jamesfletcher22/NortonAmps/Norton Amps Schematic.pdf

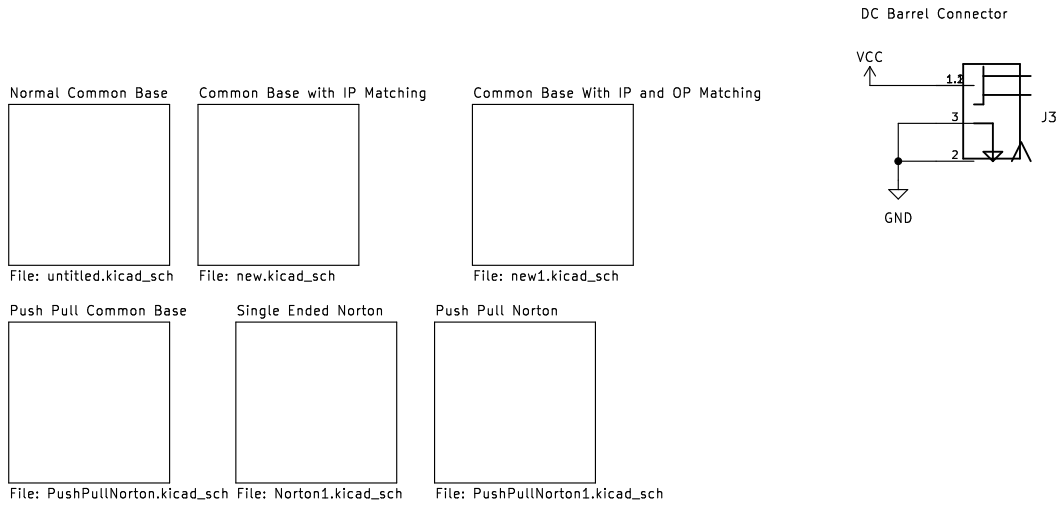
[picture p37: page 1]
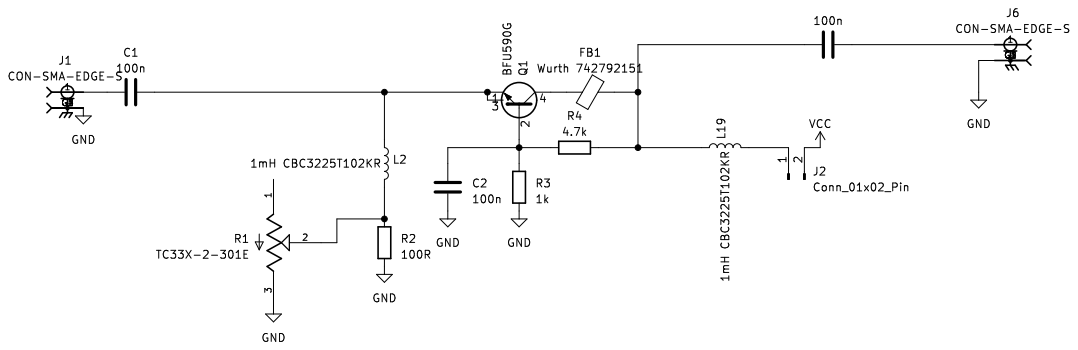
[picture p38: page 2]
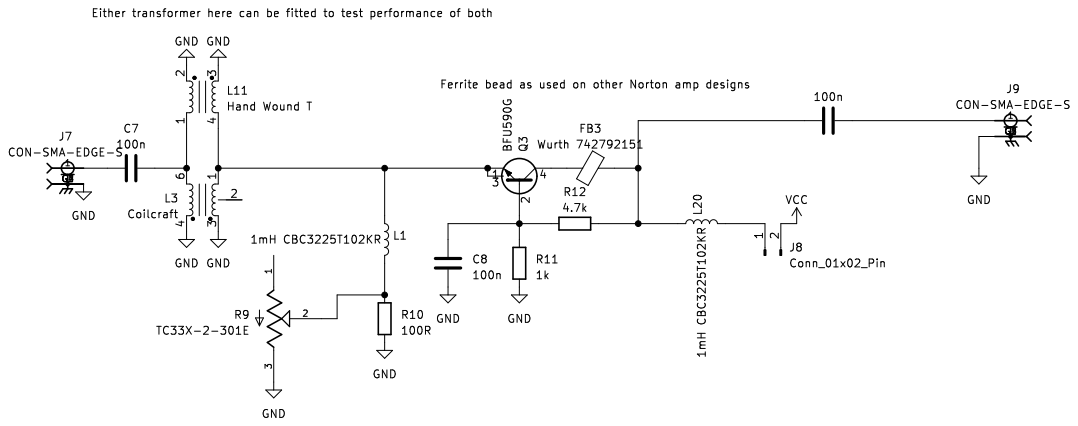
[picture p39: page 3]
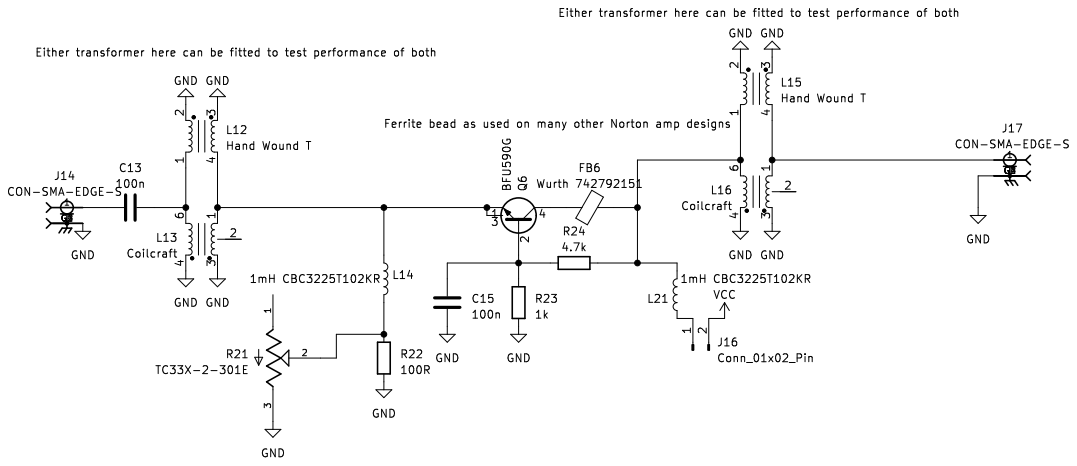
[picture p40: page 4]
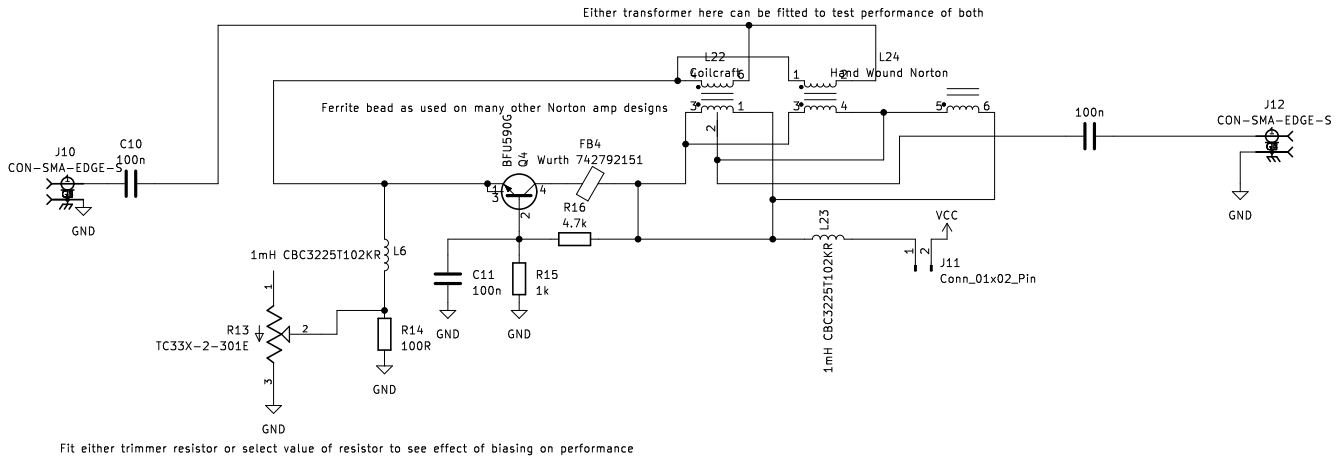
[picture p41: page 5]
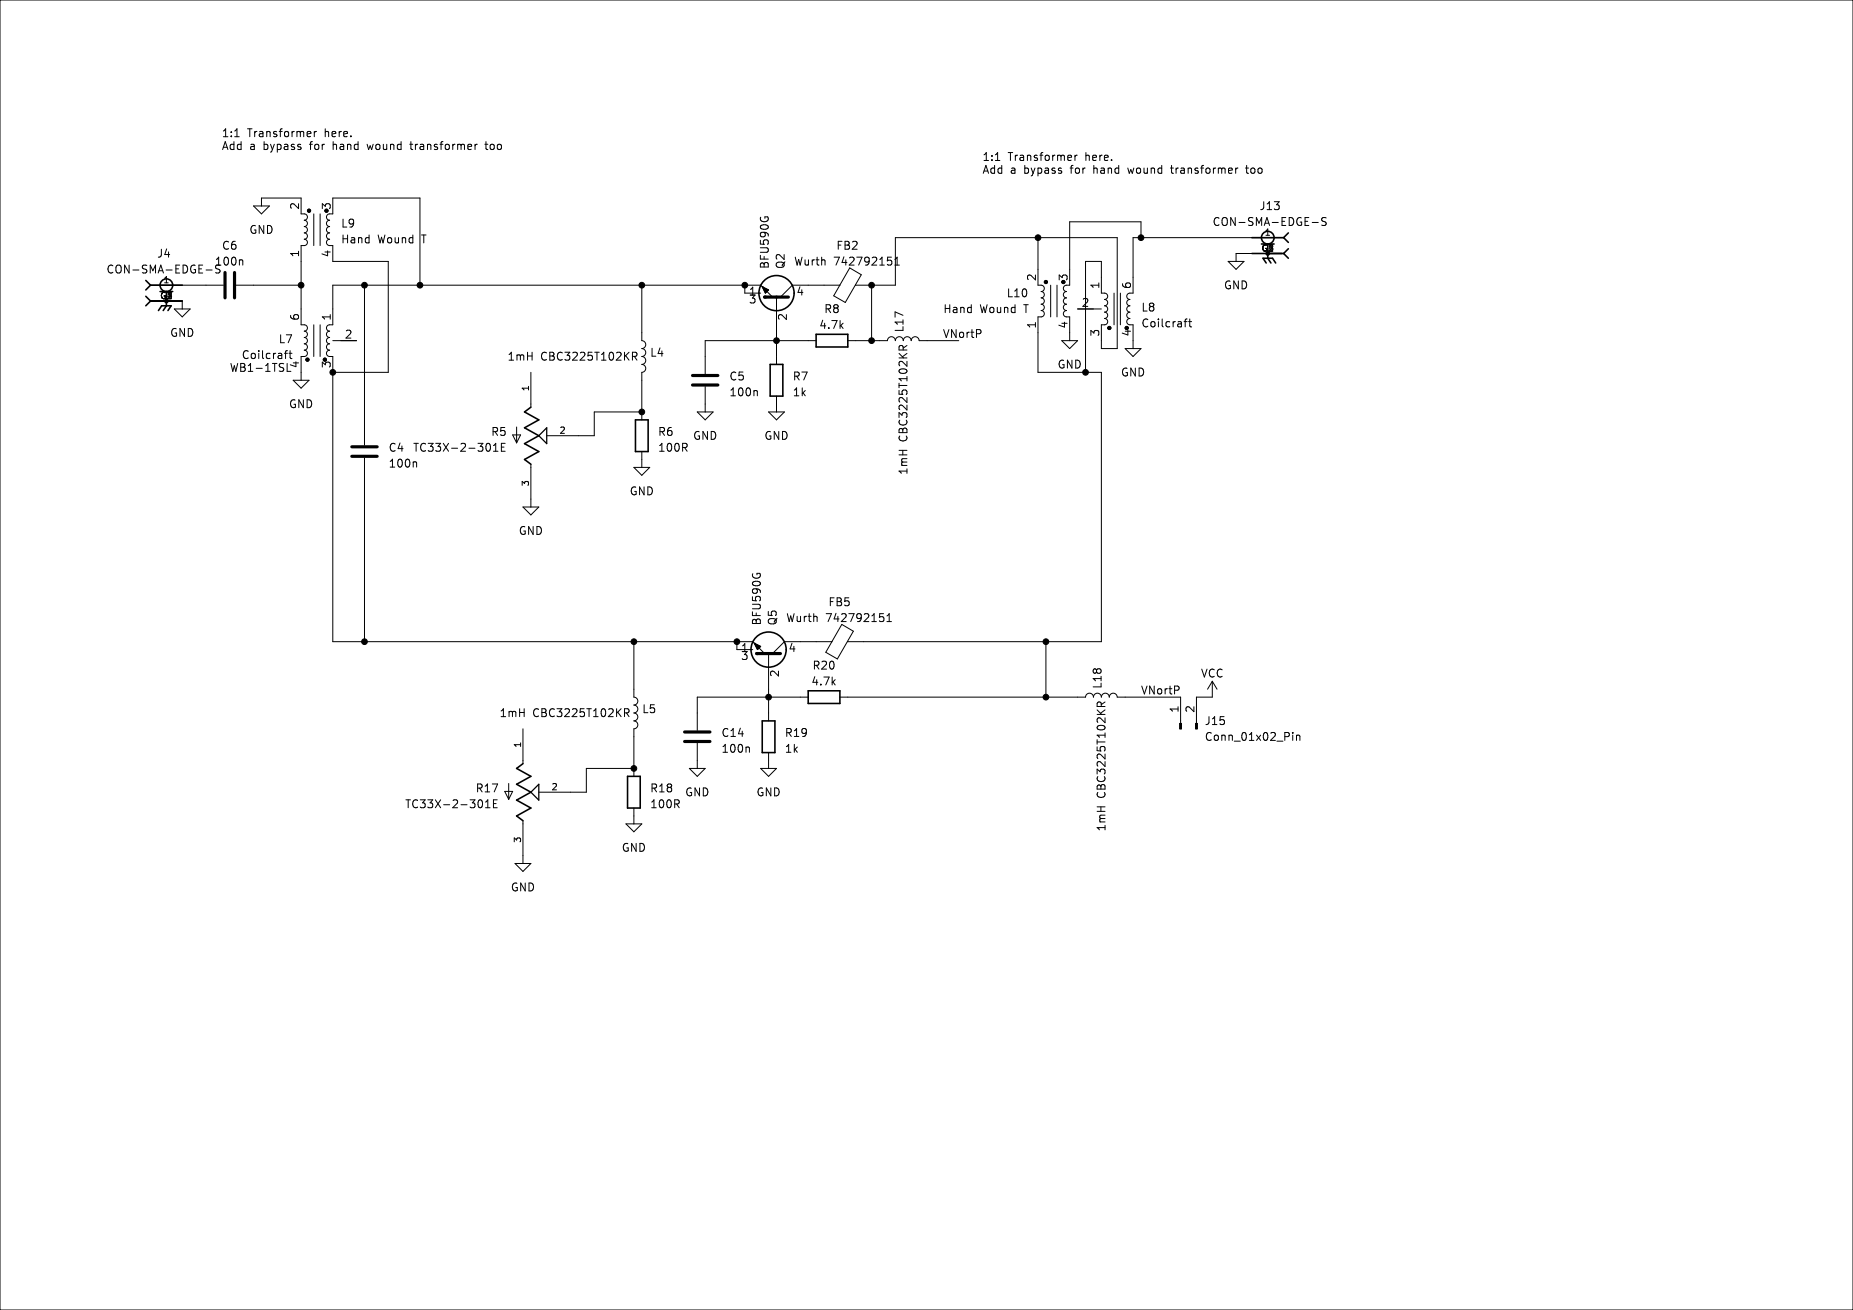
[picture p42: page 6]
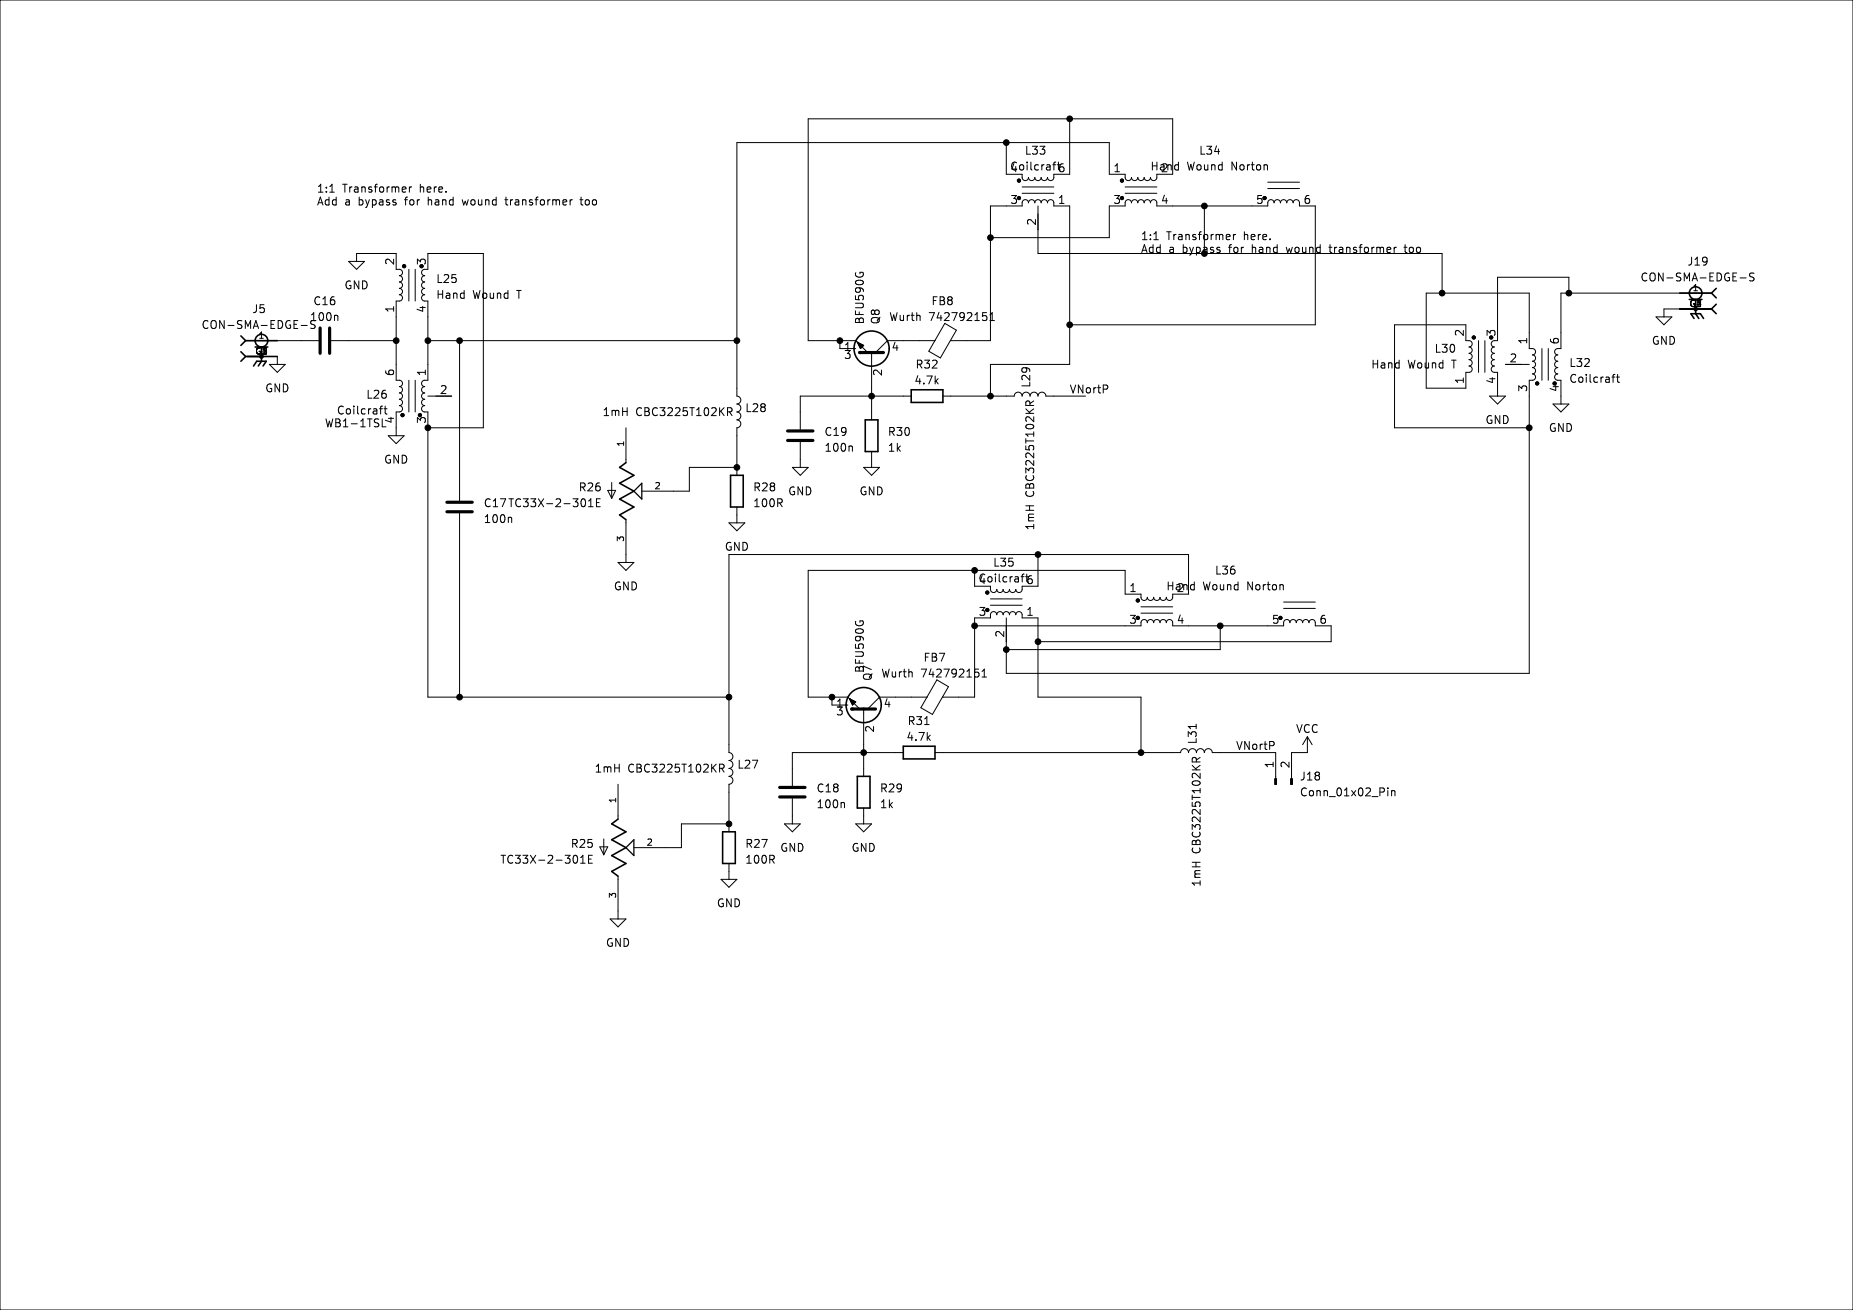
[picture p43: page 7]
